alexander-krotov/jeopardy_button/(commit log)

2024-02-11 Control panel sample.
2024-02-19 Lock button is implemented to turn off the Web interface and wifi.
2024-02-20 Stae diagrmam in flowchart format.
2024-02-20 LOCK button is documented.
